anetdev/bullseye/puck-lid-iso.png

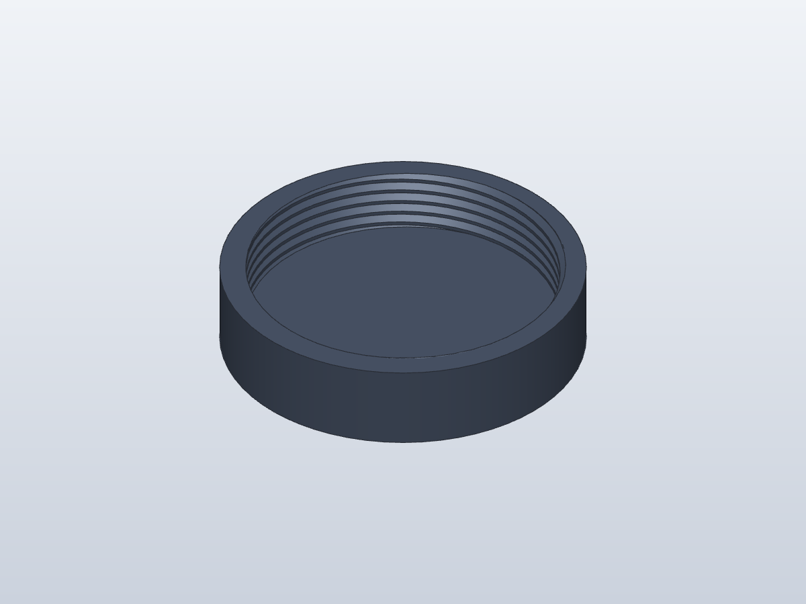
puck-lid-iso.png
