anetdev/bullseye/puck-top-bottom.png

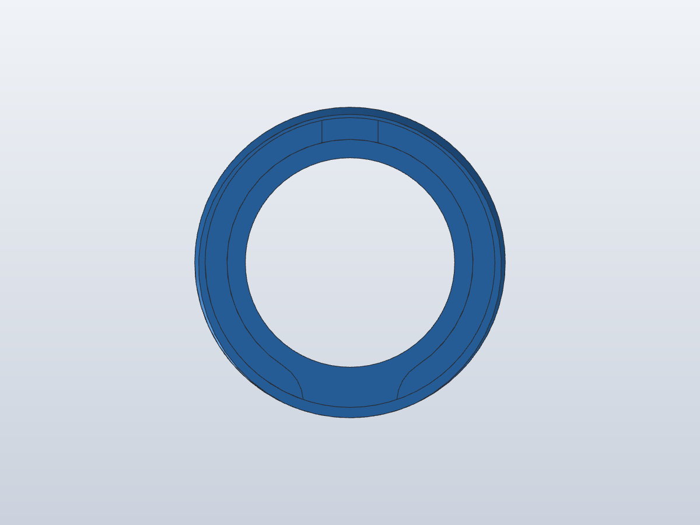
puck-top-bottom.png
