anetdev/bullseye/puck-top-iso.png

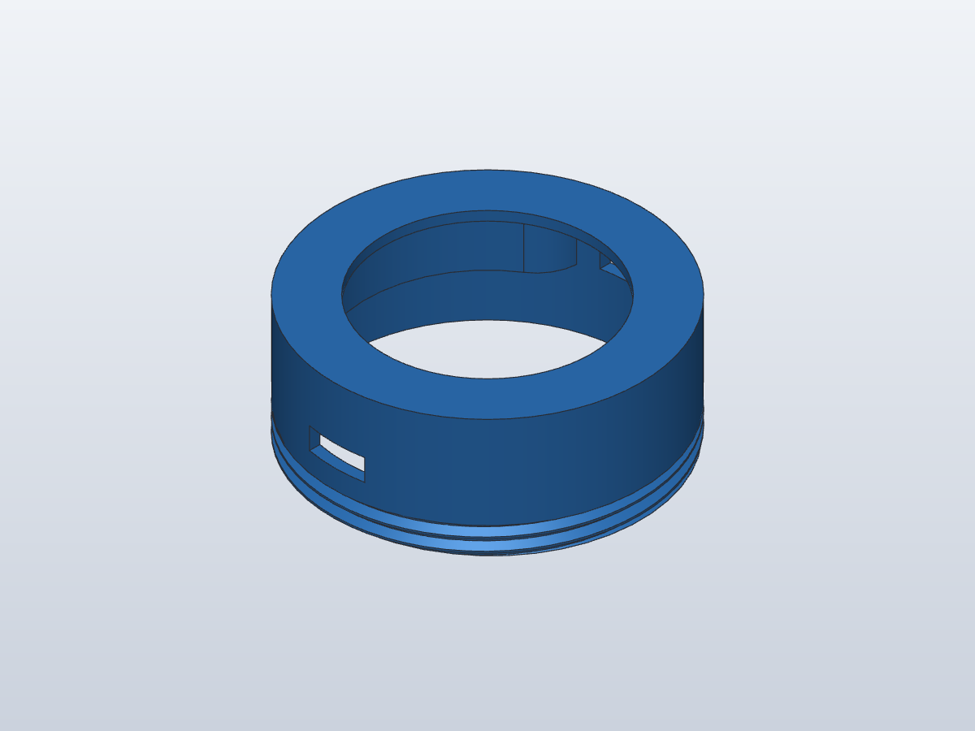
puck-top-iso.png
