anetdev/bullseye/BullsEye.step

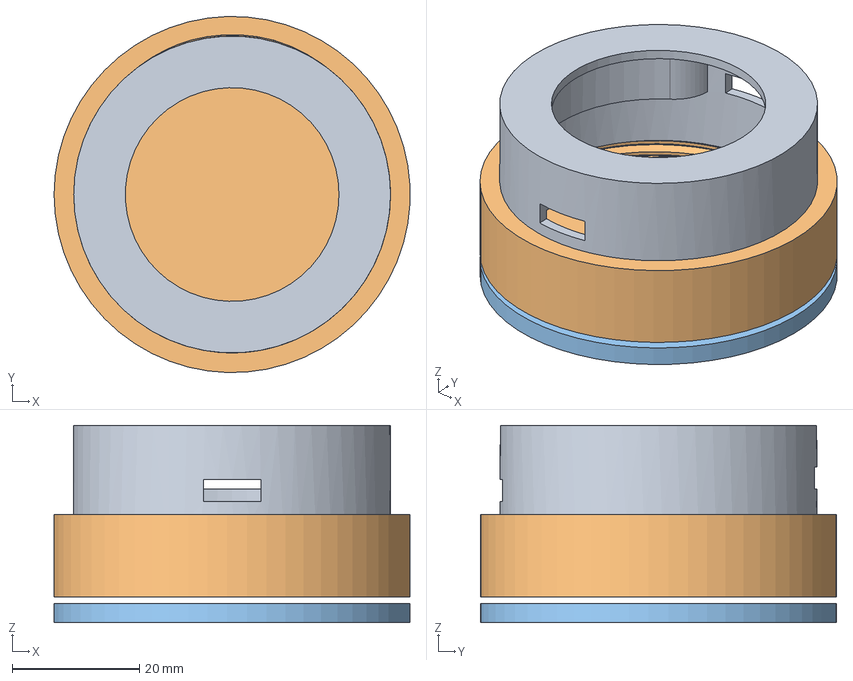
[picture p5: CAD file, 2026-11-10]
BullsEye.step
56.0 x 56.0 x 31.0 mm
