anetdev/bullseye/bullseye-assembly-top.png

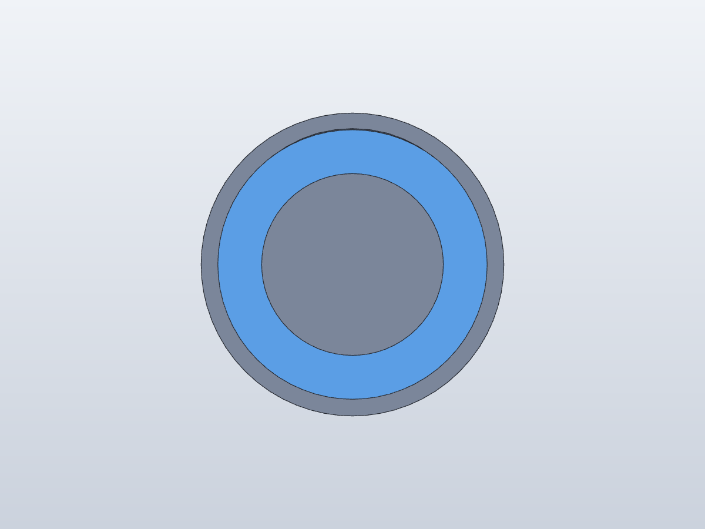
bullseye-assembly-top.png
