anetdev/bullseye/(commit log)

2026-11-03 feat: initial release of Bullseye - Smart Digital Spirit Level & Real-Time Precision Angle Guide
    [bullseye-full-plate.stl, bullseye-mount.stl, bullseye-puck-back.stl, bullseye-puck-front.stl]
2026-11-03 refactor: streamline to standalone offline mode & fix 6-axis sensor fusion
    - Remove Wi-Fi, ArduinoOTA, and WiFiManager stacks to run as a pure standalone tool
    - Shut down Wi-Fi/BT RF silicon at boot, reducing power consumption to ~35 mA (10-12+ hr battery life)
    - Implement 6-axis complementary sensor fusion fusing QMI8658 gyro rates with gravity angles
    - Dynamically scale gyro weight to 0.98 during motor vibration (isVibrating) to reject chatter
    - Fix standby backlight power leak by explicitly setting PWM brightness to 0 in enterStandby()
    - Fix relative tare math to use 3D cross-product projection instead of Cartesian subtraction
    - Upgrade battery percentage calculation to use a multi-segmen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
    [main.cpp, pin_config.h]
2026-11-03 cad: add rear-entry USB-C slide-in channel and enlarge bore clearance to 37.8mm
    [bullseye-full-plate.stl, bullseye-puck-front.stl]
2026-11-03 cad: optimize all tolerances, bores, and magnet pockets for 0.8mm nozzle on Ender 3
    [bullseye-full-plate.stl, bullseye-mount.stl, bullseye-puck-back.stl, bullseye-puck-front.stl]
2026-11-03 cad: revert magnet pocket diameter to 10.3mm and depth to 2.0mm per test fit
    [bullseye-full-plate.stl, bullseye-mount.stl, bullseye-puck-back.stl]
2026-11-04 cad: adapt puck to 54mm OD x 20mm height with 48.6mm chamber to fit 41x21x8mm LiPo battery
    [bullseye-full-plate.stl, bullseye-mount.stl, bullseye-puck-back.stl, bullseye-puck-front.stl]
2026-11-06 cad: widen screen seat to 40.2mm and USB-C bay to 23mm to match Waveshare 38.5x40.4mm teardrop outline
    [bullseye-full-plate.stl, bullseye-puck-front.stl]
2026-11-06 cad: adapt enclosure tolerances for 0.4mm nozzle and official Waveshare teardrop dimensions
    [bullseye-full-plate.stl, bullseye-mount.stl, bullseye-puck-back.stl, bullseye-puck-front.stl]
2026-11-06 cad: add 3-lug twist-lock bayonet rear lid and 6-magnet circular mount array
    [bullseye-full-plate.stl, bullseye-mount.stl, bullseye-puck-back.stl, bullseye-puck-front.stl]
2026-11-06 cad: implement JG Willis twist-snap mechanism with entry slots, locking channels, and detent bumps
    [bullseye-full-plate.stl, bullseye-puck-back.stl, bullseye-puck-front.stl]
2026-11-07 cad: add bullseye-slim.sc compact edition (48mm OD x 16.5mm height, snug rectangular battery pocket, snug 38.8mm bore, 3-lug twist-snap)
    [bullseye-slim-full-plate.stl, bullseye-slim-mount.stl, bullseye-slim-puck-back.stl, bullseye-slim-puck-front.stl]
2026-11-07 fix(slim): restore full 44mm rear insertion bore so 38.5mm display drops straight in, maintaining 50mm slim OD x 17mm height
    [bullseye-slim-full-plate.stl, bullseye-slim-mount.stl, bullseye-slim-puck-back.stl, bullseye-slim-puck-front.stl]
2026-11-07 feat(slim): replace bayonet with modeled coil screw thread lid (Φ46mm, 2.5mm pitch, 2 turns) for vibration-proof closure
    [bullseye-slim-full-plate.stl, bullseye-slim-puck-back.stl, bullseye-slim-puck-front.stl]
2026-11-07 fix(slim): offset thread coils 1mm clear of flat faces - magnet face and puck shoulder now untouched by thread profile
    [bullseye-slim-full-plate.stl, bullseye-slim-puck-back.stl, bullseye-slim-puck-front.stl]
2026-11-08 chore(cad): adopt BullsEye.step as primary mechanical design and remove legacy STLs
    [BullsEye.step, bullseye-full-plate.stl, bullseye-mount.stl, bullseye-puck-back.stl, bullseye-puck-front.stl, bullseye-slim-full-plate.stl, bullseye-slim-mount.stl, bullseye-slim-puck-back.stl]
2026-11-10 feat: add persistent desk calibration, case-friendly flasher, and update CAD assets
    [BullsEye.step]
2026-11-11 fix(battery): correct ADC divider ratio to 3:1 and add multi-sampling and CHG indicator
    [main.cpp]
